ArsenioDev/MAGFest-2023-SolderingClass/README.md

# MAGFest-2023-SolderingClass
Repository with all files for the hardware manufacturing and software to load and play with your badge after the con
