ArsenioDev/MAGFest-2023-SolderingClass/MAGFest2023SolderingClass/20.5mm led.STEP

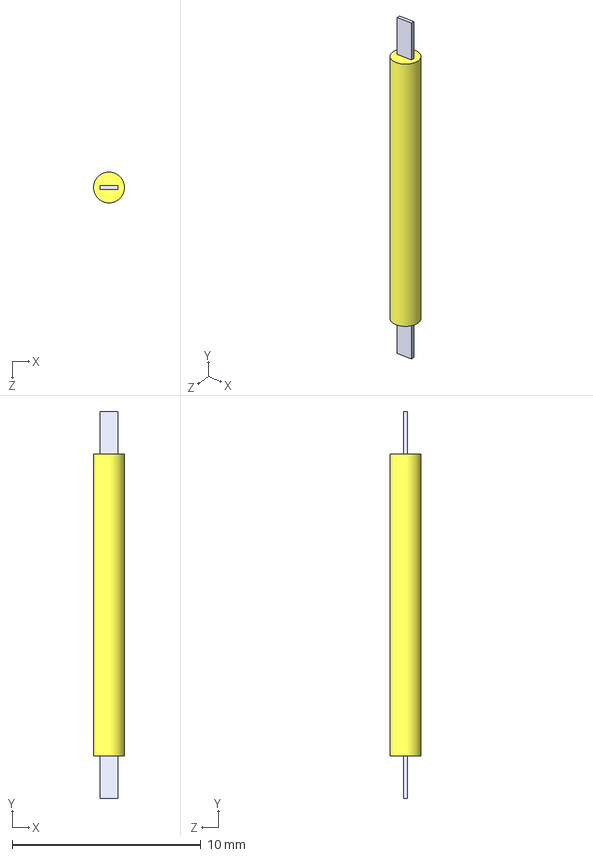
[picture p1: CAD file, 2023-12-15]
MAGFest2023SolderingClass/20.5mm led.STEP
1.64 x 20.5 x 1.64 mm
