ArsenioDev/MAGFest-2023-SolderingClass/MAGFest2023SolderingClass/MAGFest2023SolderingClass.step

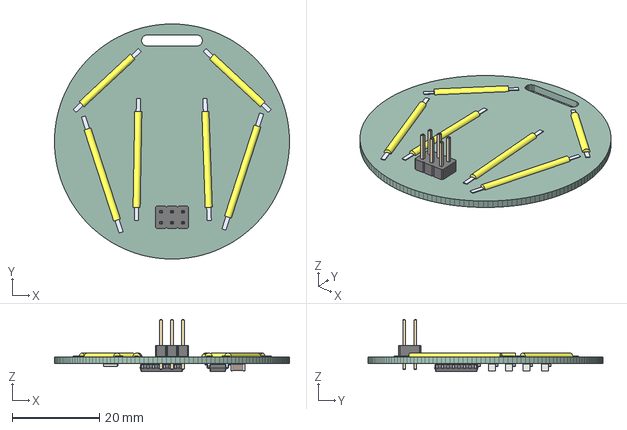
[picture p2: CAD file, 2023-12-15]
MAGFest2023SolderingClass/MAGFest2023SolderingClass.step
54.0 x 54.0 x 12.0 mm
PCB
