ArsenioDev/MAGFest-2023-SolderingClass/MAGFest2023SolderingClass/28mm led.STEP

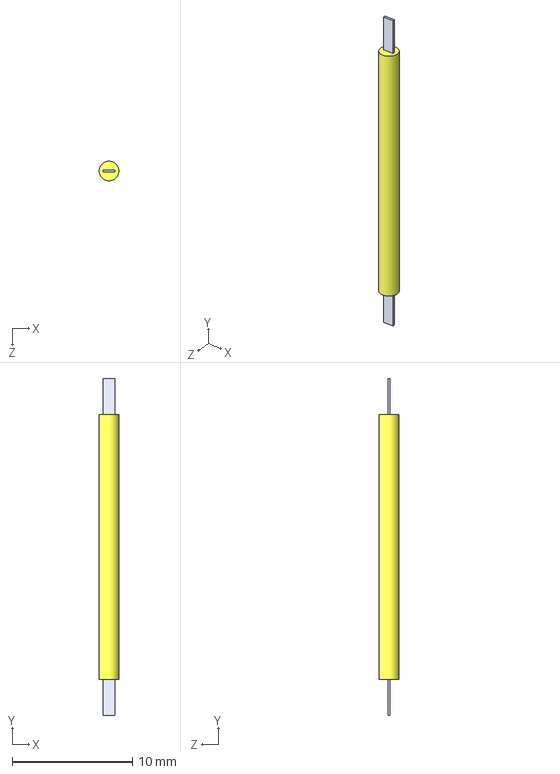
[picture p3: CAD file, 2023-12-15]
MAGFest2023SolderingClass/28mm led.STEP
1.64 x 28.0 x 1.64 mm
