ArsenioDev/MAGFest-2023-SolderingClass/(list of files, cad)

Other CAD files:
MAGFest2023SolderingClass/MAGFest2023SolderingClass.SLDASM
