ArsenioDev/MAGFest-2023-SolderingClass/(commit log)

2023-12-02 Initial ingress
    [MAGFest2023SolderingClass.kicad_pcb, MAGFest2023SolderingClass.kicad_sch]
2023-12-02 Added ignore on gitignore, and SAO header
    [MAGFest2023SolderingClass.kicad_pcb, MAGFest2023SolderingClass.kicad_sch]
2023-12-15 add M logo variant
    new layout variant with 20.5 and 28mm leds
    [20.5mm led.STEP, 28mm led.STEP, MAGFest2023SolderingClass.SLDASM, MAGFest2023SolderingClass.step, MAGFest2023SolderingClass_variant1.kicad_pcb]
2023-12-18 Generate gerbers
    [MAGFest2023SolderingClass_variant1-B_Cu.gbr, MAGFest2023SolderingClass_variant1-B_Mask.gbr, MAGFest2023SolderingClass_variant1-B_Paste.gbr, MAGFest2023SolderingClass_variant1-B_Silkscreen.gbr, MAGFest2023SolderingClass_variant1-Edge_Cuts.gbr, MAGFest2023SolderingClass_variant1-F_Cu.gbr, MAGFest2023SolderingClass_variant1-F_Mask.gbr, MAGFest2023SolderingClass_variant1-F_Paste.gbr]
2024-01-04 add variant 1.1
    flip J1 to bottom, add indicators for LED direction on silk screen
    [MAGFest2023SolderingClass_variant1-B_Cu.gbr, MAGFest2023SolderingClass_variant1-B_Mask.gbr, MAGFest2023SolderingClass_variant1-B_Paste.gbr, MAGFest2023SolderingClass_variant1-B_Silkscreen.gbr, MAGFest2023SolderingClass_variant1-Edge_Cuts.gbr, MAGFest2023SolderingClass_variant1-F_Cu.gbr, MAGFest2023SolderingClass_variant1-F_Mask.gbr, MAGFest2023SolderingClass_variant1-F_Paste.gbr]
2024-01-16 Create MAGFest 2024 Soldering Workshop.pptx
2024-01-16 Update MAGFest 2024 Soldering Workshop.pptx
